projectohid/4110_project/report_front_page.docx

EE 4142 – Sessional on Digital Signal Processing
Department of Electrical and Electronic Engineering

Khulna University of Engineering & Technology

Project Title (Experiment 5)

Design of the Driving System of the Engine of Electrical Vehicle

Submitted By

Md. Ohiduzzaman Sajol – 2003043

Amit Kumar Das (2003056)

Md. Washim Molla (2003058)

S.M. Fahim Shahriar (2003059)

Md. Mustafijur Rahman (2003057)

Sadman Shamyo (2003060)

Submitted To

Dr. Md. Habibullah

Professor, Dept. of EEE, KUET

and

Md. Sajjad Hossain

Lecturer, Dept. of EEE, KUET

Date of Submission

November 10, 2025
