projectohid/4110_project/(list of files, drawings)

Other design files:
Project Backups/Power_electronics_ckt_figure [20251031, 02-13-44].pdsprj
Updated_power_electronics_ckt_figure.pdsprj
