projectohid/4110_project/(commit log)

2025-10-17 Initial arduino program
2025-10-23 Updated motor_drive_sketch.ino
2025-10-23 Deleted Power_electronics_ckt_figure.PDF
    This figure is to be changed
2025-10-23 Add files via upload
    Look at this new proteus file
    [Power_electronics_ckt_figure.pdsprj]
2025-10-24 Updated the arduino code and Made some changes to the gui app to make it function - not tested yet
2025-10-24 Receiving acknowledgement from the arduino and displaying it to the MATLAB command window
2025-10-30 matlab app is working but the arduino code needs a major fix
    [Power_electronics_ckt_figure [20251031, 02-13-44].pdsprj, Power_electronics_ckt_figure.pdsprj]
2025-10-31 Deleted Power_electronics_ckt_figure.pdsprj
    [Power_electronics_ckt_figure.pdsprj]
2025-10-31 Updated_circuit_diagram
    I am facing troubles in simulation due to small time steps ( ? ) or cpu overloading. But motor is running well IRL.
    [Updated_power_electronics_ckt_figure.pdsprj]
2025-11-07 Deleted motor_drive_sketch/motor_drive_sketch.ino
2025-11-09 Data files
    [Project_graph.xlsx]
2025-11-09 Data file
    [Project_graph.xlsx]
